desiFish/EPaper-Display-Weather-Clock/README.md

<div align="center">
  <h1>🌡️ Minimalistic E-Paper Weather Station</h1>
  <p>
    
    
    
    
  </p>
  <p>
    
    
    
    
  </p>
</div>

<p align="center">
  <i>🌈 A beautiful, eco-friendly weather station powered by E-Paper display! 🌱</i>
</p>

</div>

> ⚠️ **IMPORTANT**: Please read the [Notes & Warnings] section carefully before proceeding with this project. It contains crucial safety information about battery configuration, charging, and sensor placement.

<div align="center">

### 🌟 Smart • Efficient • Eco-Friendly 🌟

</div>

---

## 📝 Schematics

<div align="center">
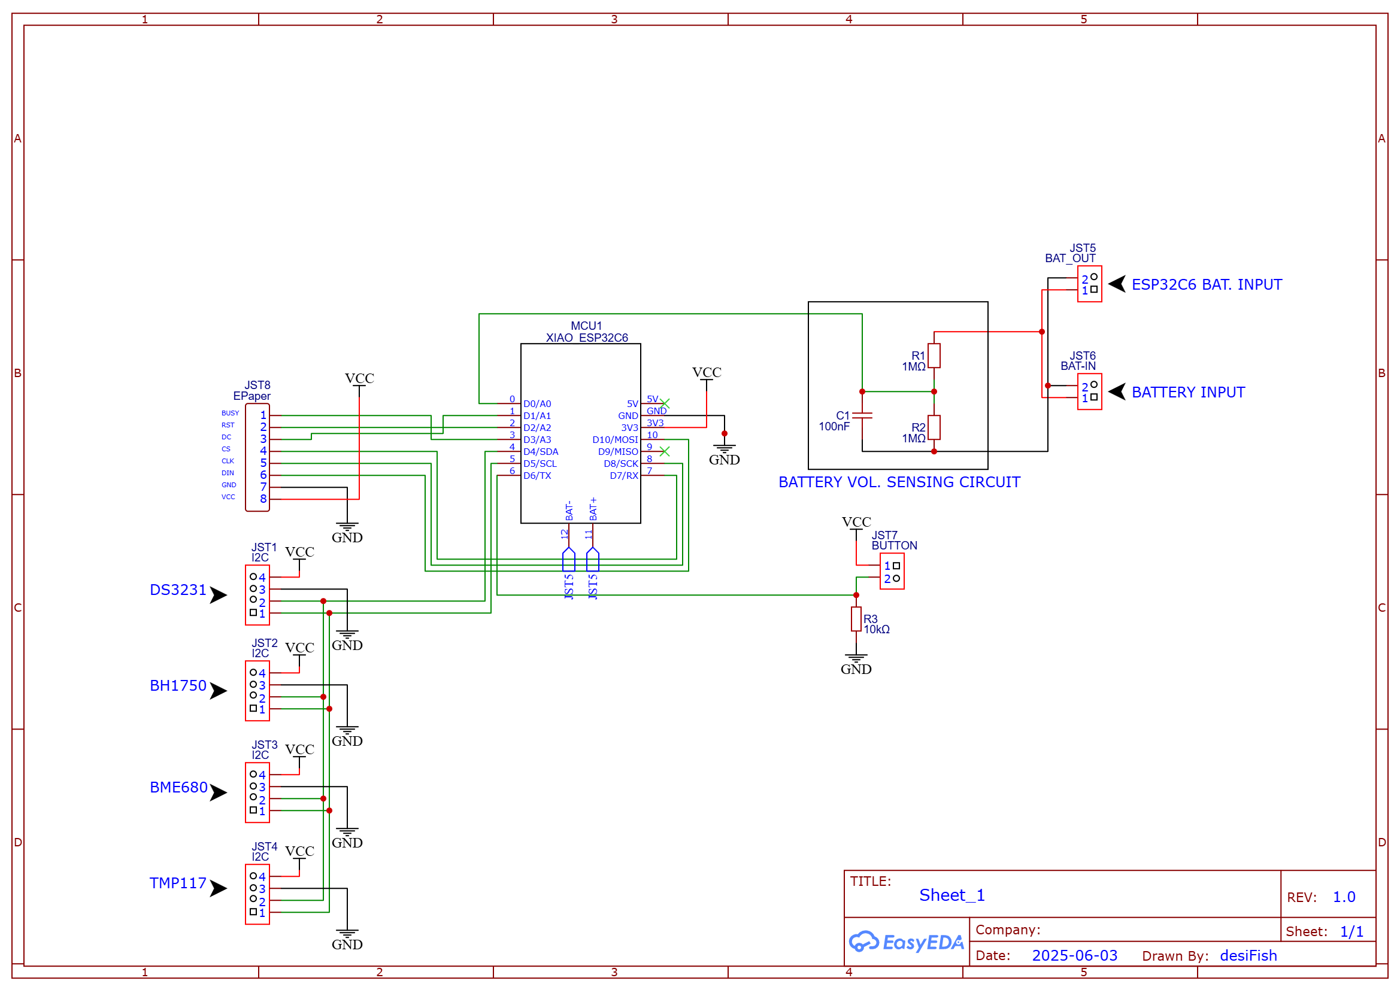
[picture p1: resources/schematic.png]
Circuit Schematics
  
  <p><i>Project Circuit Schematics</i></p>
</div>

## 🛠️ Hardware Components

<table>
  <tr>
    <td>🎯 <b>Tested On</b></td>
    <td>
      • Seeed Studio XIAO ESP32 C3<br>
      • Seeed Studio XIAO ESP32 C6
    </td>
  </tr>
  <tr>
    <td>📟 <b>Display</b></td>
    <td>Waveshare 4.2inch TriColor 400x300 E-paper (15s refresh)</td>
  </tr>
  <tr>
    <td>🌡️ <b>Sensors</b></td>
    <td>
      • TMP117 (Temperature)<br>
      • BH1750 (Light sensing)<br>
      • DS3231 (Time keeping)<br>
      • BME680 (Humidity & pressure)
    </td>
  </tr>
  <tr>
    <td>🔋 <b>Power</b></td>
    <td>LFP 2x4000mAh (8000mAh total) Lithium Iron Phosphate Battery (IFR26700)</td>
  </tr>
  <tr>
    <td>🔌 <b>Other</b></td>
    <td>2xBMS, capacitors, resistors, connectors, etc.</td>
  </tr>
</table>

## 📱 Key Features & Updates

<table>
<tr>
<td width="50%" align="center">
  
### 🆕 Latest Version
[**v0.4.0**](https://github.com/desiFish/ESP32-ePaper-Display-Weather-Clock/releases/tag/v0.4.0)
- 🔧 Enhanced overall system efficiency
- 💾 Improved readability
  
</td>
<td width="50%" align="center">

### 🎯 Coming Soon
- 📱 Web browser integration
- 🌐 Enhanced weather data graph
- 🎨 New display layouts
  
</td>
</tr>
</table>

## ⭐ Core Features

<div align="center">

🌡️ Medical-grade Temperature | 💧 Humidity & Pressure | 🔋 Smart Battery | 🌍 Weather Data
:-------------------------:|:-------------------------:|:-------------------------:|:-------------------------:
±0.1°C Precision | Real-time Monitoring | Intelligent Power Mgmt | Global Forecasting
`TMP117 Sensor` | `BME680 Sensor` | `2000+ Cycles` | `OpenWeatherMap`

</div>

### 🎮 Smart Features
• 🌙 Moon Phase & Day/Night Tracking  
• 🔄 Auto WiFi Configuration  
• ⏰ Power-efficient Sleep Modes  
• 📊 Environmental Monitoring

## ⚡ Power Performance

<div align="center">
  
### 🔋 Power Optimization Results




</div>

<div align="center">
<table style="width: 80%; margin: 20px auto; border: 2px solid #4CAF50; border-radius: 10px; padding: 15px;">
<tr>
<td style="text-align: center; background-color: #f8f9fa;">
<h3>🚀 Coming Soon: Ultra-Low Power Mode</h3>
<p style="color: #155724; background-color: #d4edda; padding: 10px; border-radius: 5px;">
Using SparkFun TPL5110 Timer + Power Management Board:<br>
Sleep Current Draw: 20µA → 35nA<br>
<b>That's a 571,328% reduction in sleep power consumption!</b>
</p>
<details>
<summary>💡 How it works</summary>
<p>The TPL5110 completely cuts power to the system between updates, reducing standby current to near-zero levels. This improvement will dramatically extend battery life!</p>
</details>
</td>
</tr>
</table>
</div>

> 📊 **Performance Metrics**
> 
> After recent code optimizations, power efficiency has significantly improved:
> 
> | Mode | Duration (Awake) | Status |
> |------|----------|---------|
> | Active-Active | ~27s |  |
> | Sleep-Active-Sleep | ~20s |  |
> | Sleep-to-Sleep | <1s |  |
>
> ✨ **Key Improvements**:
> - CPU power thoroughly monitored and conserved
> - Optimized mode transitions
> - Minimal wake time in sleep cycles

## 📊 Battery Performance

> 📝 **Note**: Historical data below is from testing with Li-ion ICR batteries. The shorter duration in cycles 2 and 3 (49 and 48 days vs 73 days) was due to incomplete charging (batteries not reaching full 4.2V). New performance data with 8000mAh LFP batteries (which are more cost-effective) is being collected.

### ICR Battery Data (OLD)
<details>
<table>
  <tr>
    <th>Cycle</th>
    <th>Duration</th>
    <th>Details</th>
  </tr>
  <tr>
    <td>First Cycle</td>
    <td>73 Days or 2 Months, 12 Days</td>
    <td>06/05/2024 - 17/07/2024</td>
  </tr>
  <tr>
    <td>Second Cycle</td>
    <td>49 Days</td>
    <td>~7 weeks</td>
  </tr>
  <tr>
    <td>Third Cycle</td>
    <td>48 Days</td>
    <td>~7 weeks</td>
  </tr>
</table>
</details>

### LFP Battery Data (NEW)
<table>
  <tr>
    <th>Cycle</th>
    <th>Duration</th>
    <th>Details</th>
  </tr>
  <tr>
    <td>First Cycle</td>
    <td>107 Days or 3 Months, 17 Days</td>
    <td>09/01/2025 - 18/04/2025</td>
  </tr>
  <tr>
    <td>Second Cycle</td>
    <td>134 Days or 4 Months, 12 Days</td>
    <td>18/04/2025 - 30/08/2025</td>
  </tr>
  <tr>
    <td>Third Cycle</td>
    <td>TBD</td>
    <td>13/08/2026 - TBD</td>
  </tr>
</table>

### Current Consumption
> ⚠️ **Note**: Precise current consumption measurements for the entire project are not available due to equipment limitations. Please refer to the Battery Performance section above for real-world usage data and longevity estimates.

## 📸 Gallery

<table style="border-spacing: 10px; border-collapse: separate;">
  <tr>
    <td width="33%" style="padding: 0;">
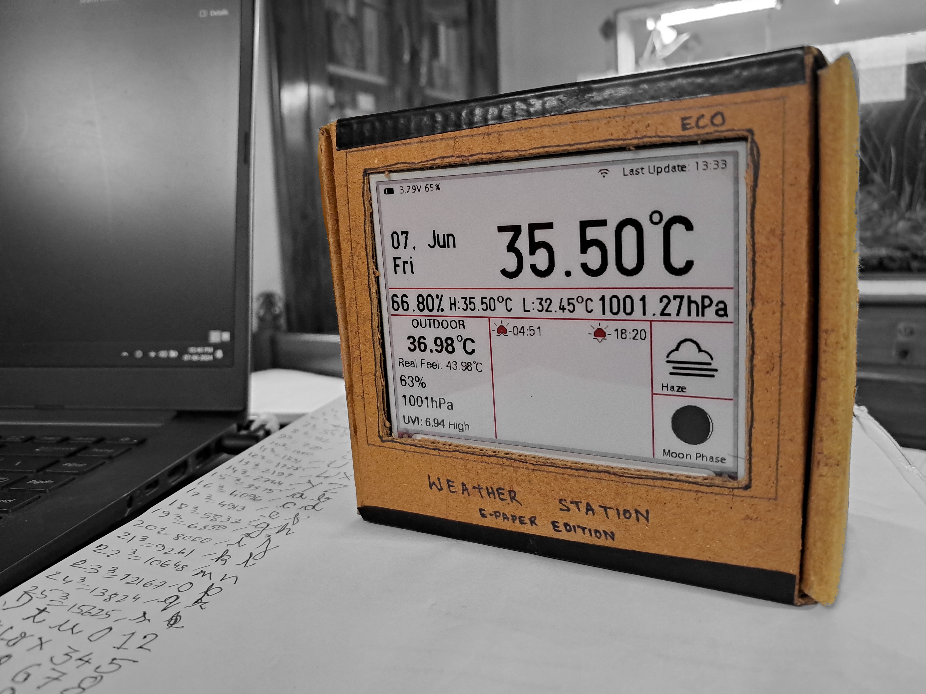
[picture p2: resources/epd.jpg]
Clock Normal Mode
      
      <p align="center"><i>Clock Normal Mode</i></p>
    </td>
    <td width="33%" style="padding: 0;">
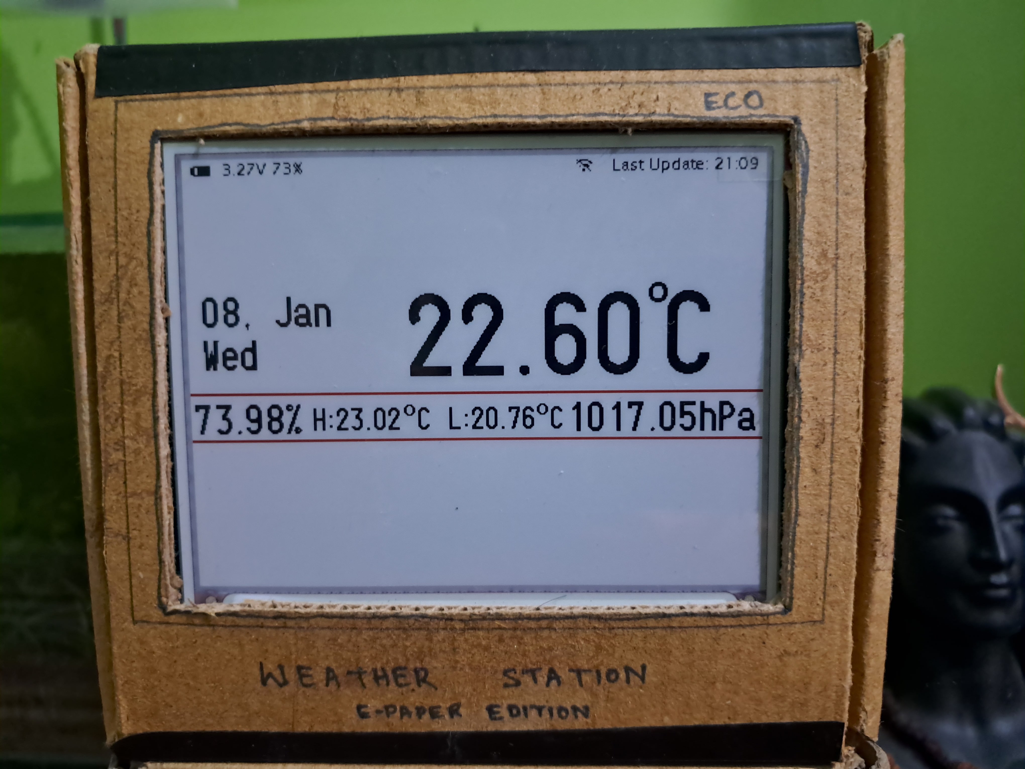
[picture p3: resources/epd2.jpg]
Clock Power Conserved Mode
      
      <p align="center"><i>Clock Power Conserved Mode</i></p>
    </td>
    <td width="33%" style="padding: 0;">
      Side View 1
      <p align="center"><i>Side View 1</i></p>
    </td>
  </tr>
  <tr>
    <td width="33%" style="padding: 0;">
      Back View
      <p align="center"><i>Back View</i></p>
    </td>
    <td width="33%" style="padding: 0;">
      Side View 2
      <p align="center"><i>Side View 2</i></p>
    </td>
    <td width="33%" style="padding: 0;">
      Top View
      <p align="center"><i>Top View</i></p>
    </td>
  </tr>
  <tr>
    <td width="33%" style="padding: 0;">
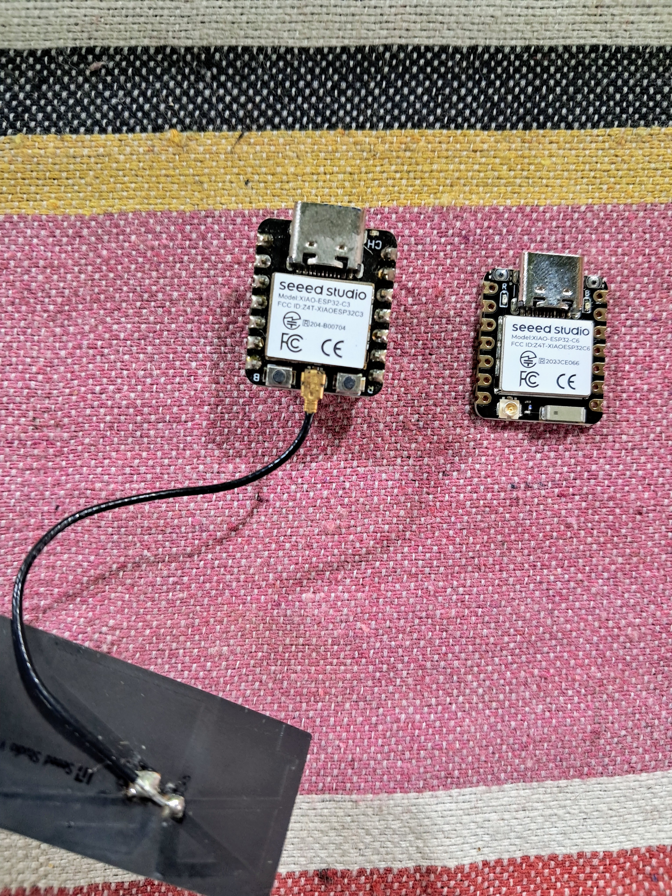
[picture p4: resources/epd7.jpg]
ESP32 Compared
      
      <p align="center"><i>ESP32 Compared</i></p>
    </td>
    <td width="33%" style="padding: 0;">
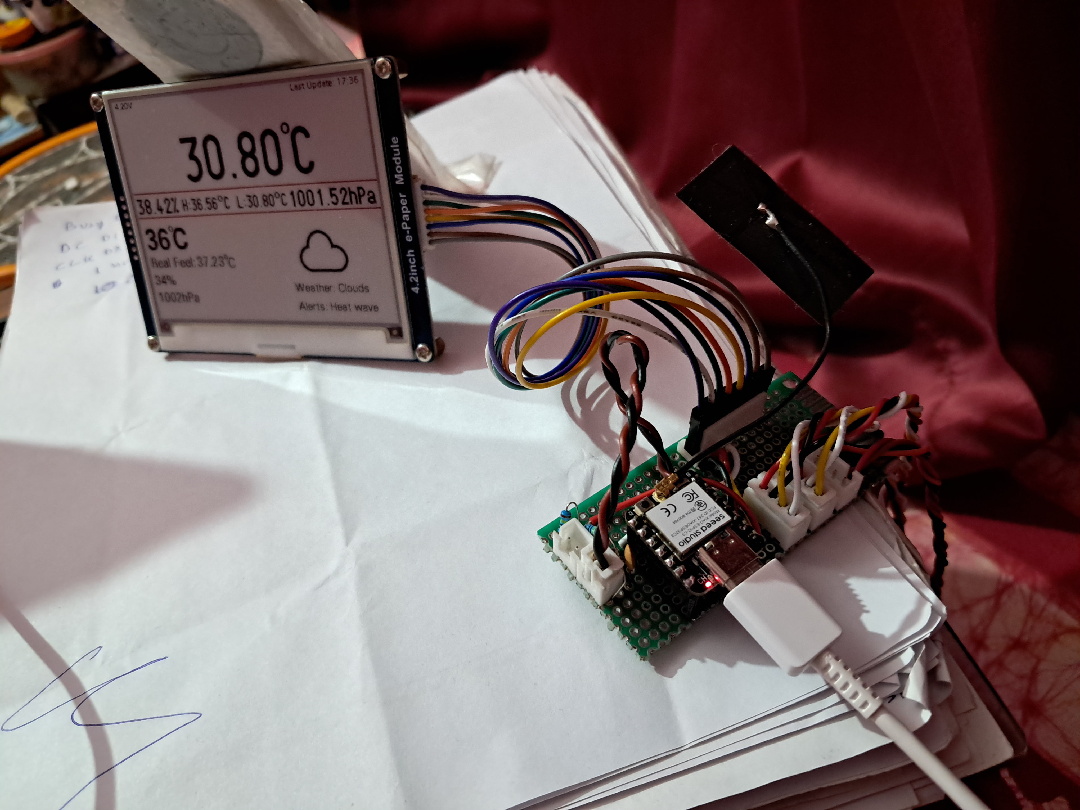
[picture p5: resources/epd8.jpg]
Testing
      
      <p align="center"><i>Testing</i></p>
    </td>
    <td width="33%" style="padding: 0;">
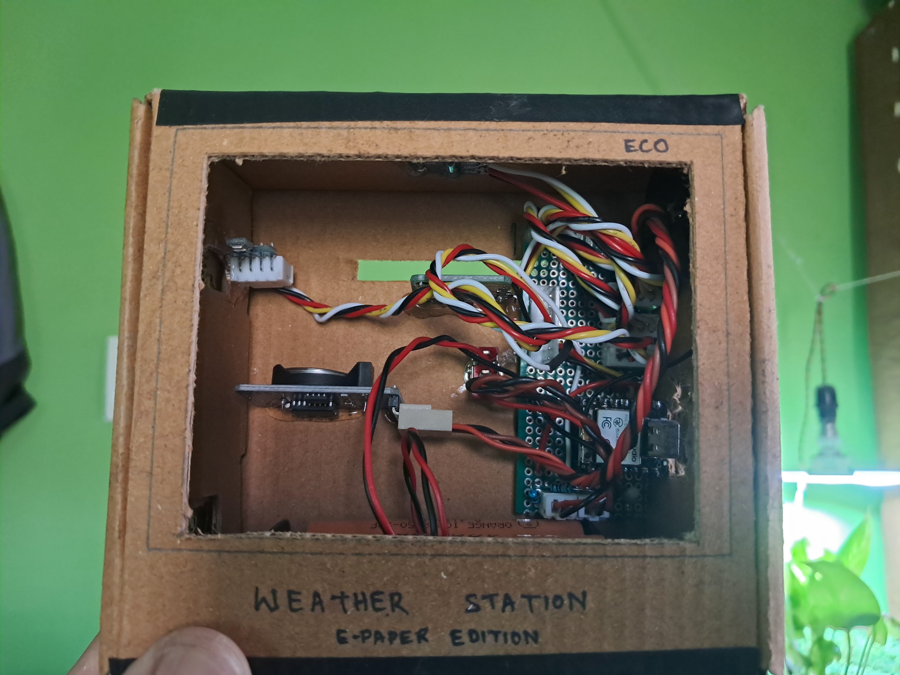
[picture p6: resources/epd9.jpg]
Integration
      
      <p align="center"><i>Integration</i></p>
    </td>
  </tr>
  <tr>
    <td width="33%" style="padding: 0;">
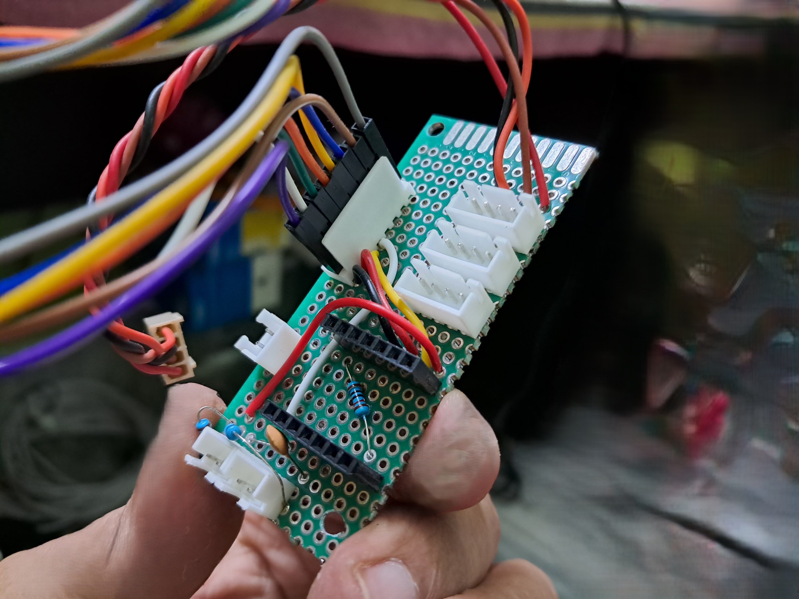
[picture p7: resources/epd10.jpg]
Mainboard Front
      
      <p align="center"><i>Mainboard Front</i></p>
    </td>
    <td width="33%" style="padding: 0;">
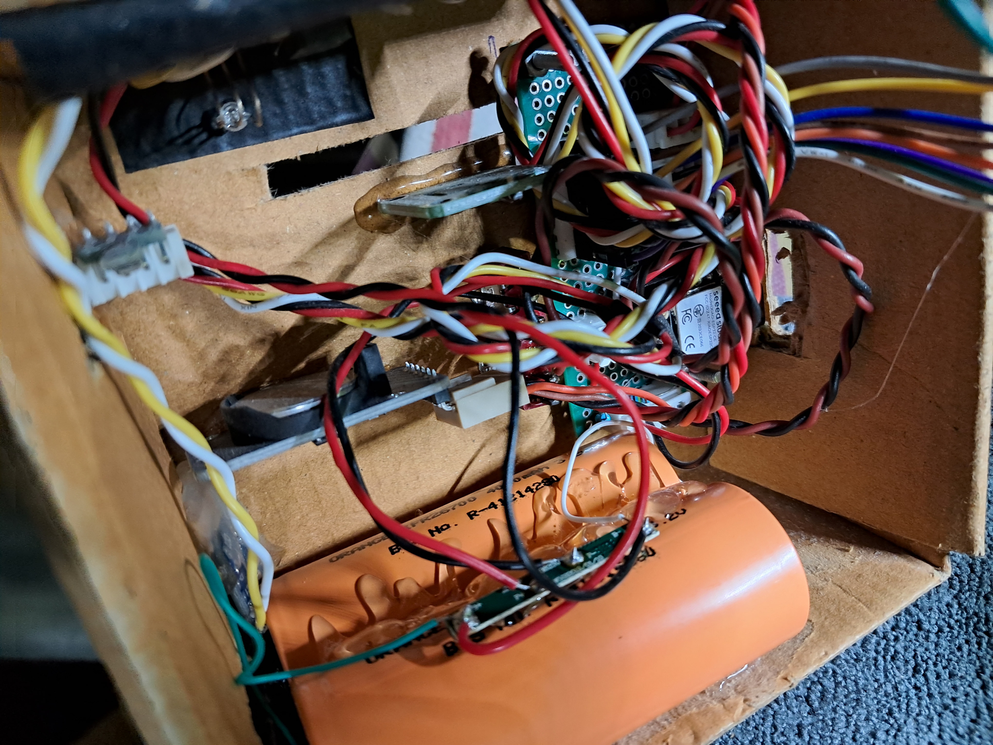
[picture p8: resources/epd11.jpg]
Internal 1
      
      <p align="center"><i>Internal 1</i></p>
    </td>
    <td width="33%" style="padding: 0;">
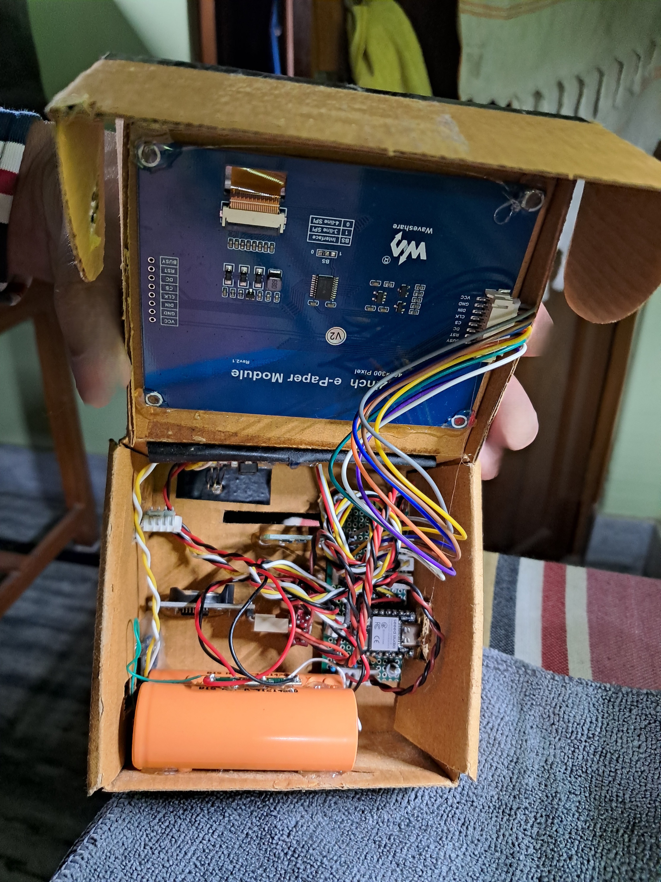
[picture p9: resources/epd12.jpg]
Internal 2
      
      <p align="center"><i>Internal 2</i></p>
    </td>
  </tr>
  <tr>
    <td width="33%" style="padding: 0;">
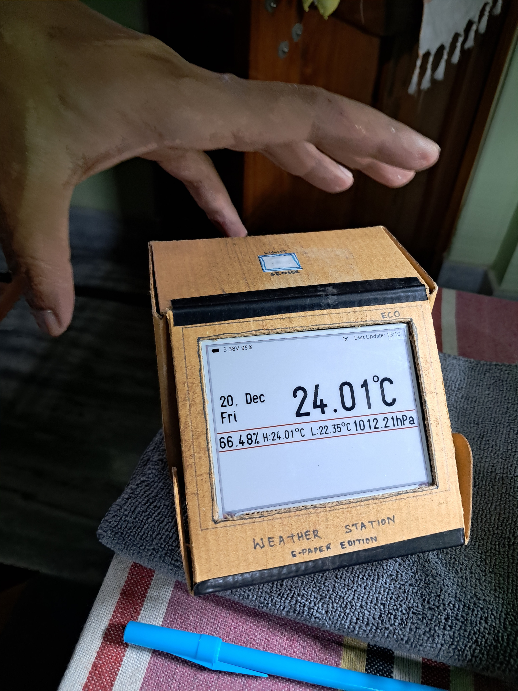
[picture p10: resources/epd13.jpg]
Facelift Clock
      
      <p align="center"><i>Facelift Clock</i></p>
    </td>
    <td width="33%" style="padding: 0;">
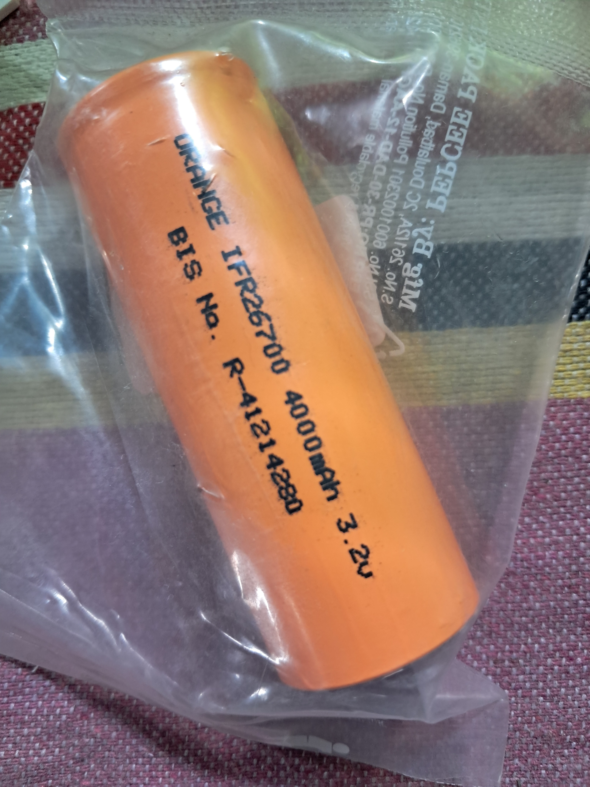
[picture p11: resources/epd14.jpg]
LiFePO4 Cell 4000mAh
      
      <p align="center"><i>LiFePO4 Cell 4000mAh</i></p>
    </td>
    <td width="33%" style="padding: 0;">
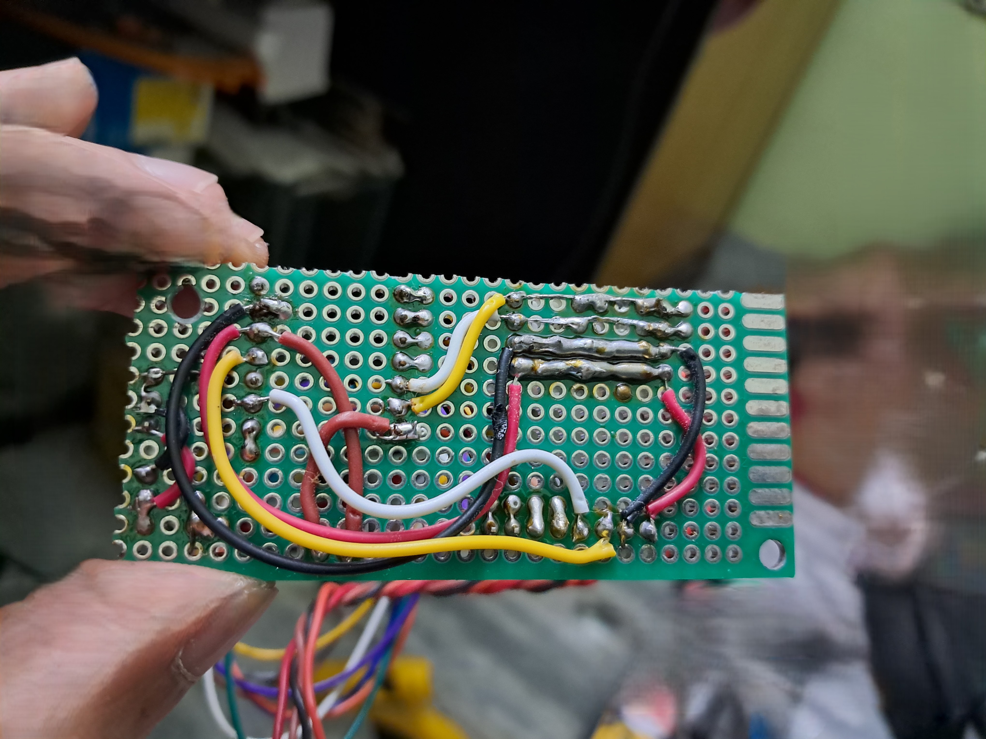
[picture p12: resources/epd15.jpg]
Mainboard Back
      
      <p align="center"><i>Mainboard Back</i></p>
    </td>
  </tr>
</table>

## 🌱 Eco-Friendly Features

- 📱 E-Paper Display (no backlight needed)
- 🔋 LiFePO4 Batteries (Lithium Iron Phosphate)
  - ✅ Cobalt-free chemistry, reducing environmental impact
  - ✅ 2-3x longer lifespan than traditional Li-ion
  - ✅ Non-toxic and more stable chemistry
  - ✅ Better recyclability due to simpler composition
- 📦 Recycled cardboard construction
- 💡 Smart light sensor for power saving

## 💫 Technical Specifications

<details>
<summary>🧠 Core System</summary>

### Core Components
- 💻 **XIAO ESP32 C6** (Recommended)
  - 32-bit RISC-V single-core CPU up to 160MHz
  - 320KB SRAM, 4MB Flash
  - WiFi 6 & Bluetooth 5.0
  - Ultra-low power consumption: ~14µA in deep sleep ([Source](https://sigmdel.ca/michel/ha/xiao/xiao_esp32c6_intro_en.html#deep_sleep))
    - Note: 14-15µA deep sleep current only achievable when power is supplied through battery pins (BAT+ and BAT-)
  - 11 Digital/Analog pins
  - USB-C interface
  - ⚠️ May experience reduced WiFi range due to integrated PCB antenna
    - Consider ESP32 C3 variant with external antenna for better signal strength
    - Signal strength highly dependent on enclosure material and placement

### Pin Differences Between C3 and C6
<div align="center">
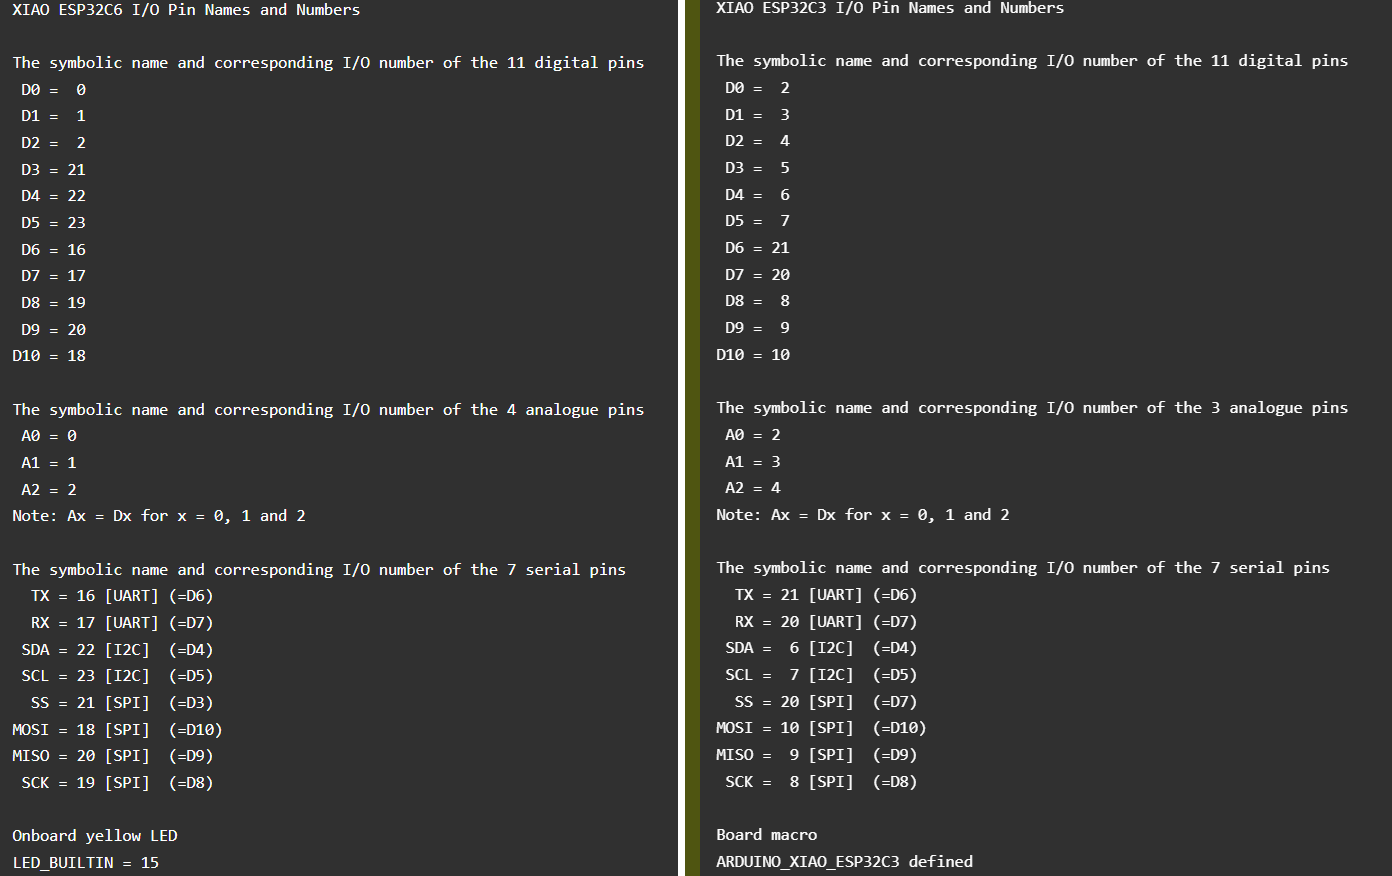
[picture p13: resources/epd18.png]
<br>
<table>
</table>
<p><i>Source: <a href="https://sigmdel.ca/michel/ha/xiao/xiao_esp32c6_intro_en.html#deep_sleep">sigmdel.ca</a></i></p>
</div>

### Power Consumption Comparison
- ⚡ **Deep Sleep Current**:
  - XIAO ESP32 C6: ~25µA total
    - 14.3µA from ESP32C6 core ([Source](https://sigmdel.ca/michel/ha/xiao/xiao_esp32c6_intro_en.html#deep_sleep))
    - ~11µA from all peripheral devices in standby (RTC, sensors, etc.)
  - XIAO ESP32 C3: Higher deep sleep current (~43µA, tested)
  - XIAO ESP32 S3: Potentially lower deep sleep current (~11.9µA, untested)
    - Not used due to project's modest performance needs
    - Could be viable alternative for maximum battery life

</details>

<details>
<summary>📡 Sensors & Connectivity</summary>

### Sensors
- 🌡️ TMP117 High-Precision Temperature Sensor
  - ±0.1°C (max) from -20°C to +50°C
  - 16-bit resolution (0.0078°C)
  - Low power: 3.5µA in shutdown mode
  - Temperature range: -55°C to +150°C
  
- 💨 Bosch BME680 Environmental Sensor
  - Humidity: ±3% accuracy
  - Pressure: ±0.6 hPa absolute accuracy
  - Gas sensor for air quality
  - Temperature range: -40°C to +85°C
  
- 💡 BH1750 Light Sensor
  - 1 - 65535 lux range
  - 16-bit resolution
  - Spectral responsivity close to human eye
  - Low power: 120µA active mode
  
- ⏰ DS3231 RTC Module
  - Accuracy: ±2ppm (±0.432 sec/day)
  - Temperature compensated crystal
  - Battery backup support
  - -40°C to +85°C operating range

</details>

<details>
<summary>⚡ Power System</summary>

### Power & Display
- 🔋 IFR26700 LiFePO4 Battery
  - Nominal voltage: 3.2V
  - Capacity: 4000mAh (8000mAh total with 2 cells)
  - Cycle life: >1000 min. cycles
  - Size: 26mm × 70mm
  - Max discharge current: 8A
  - Operating temperature: -20°C to +60°C
  - Self-discharge rate: <3% monthly
  - Battery critical threshold: 30%
    - Higher threshold significantly increases battery lifecycle ([Source](https://batteries.intercel.eu/knowledge-center/battery-technology/lithium-batteries/lifepo4-batteries/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,continue%20where%20other%20batteries%20stop.))
    - Urges to recharge at 30% remaining capacity
    - Preserves cell health for longer service life
    - Implemented in firmware via critBattPercent constant

- ⚡ TP5000 Charging Module
  - Input voltage: 4.5-8V
  - Charging current: 1000mA (adjustable)
  - Charging accuracy: ±1.5%
  - LiFePO4 mode: 3.6V cutoff
  - Over-voltage protection
  - Temperature protection
  - Short circuit protection

- 📟 Waveshare 4.2" E-Paper Display
  - Resolution: 400×300 pixels
  - Three colors: Black, White, Red
  - Active area: 84.8mm × 63.6mm
  - Refresh time: 15 seconds
  - Viewing angle: >170°
  - Operating voltage: 3.3V
  - Ultra-low power consumption
  - No backlight needed
  - SPI interface

</details>

<details>
<summary>📟 Display & Ghosting</summary>

### E-Paper Display Ghosting
- 👻 **Ghosting Issue**: Even after using full scan/update mode, ghosting can occur
  - Red lines may appear over black background
  - Occurs when same elements stay static for extended periods
  
- 🛡️ **GhostProtek Mode**
  - Automatically inverts display colors periodically
  - Activates after predetermined number of boots
  - Prevents static elements from burning in
  - Helps maintain display longevity
  - Experimental feature to reduce ghosting artifacts

</details>

## 🔧 Setup & Configuration

### Initial Setup
1. 📱 Power on the device
2. 🔄 Connect to `WCLOCK-WIFI-MANAGER` WiFi network
3. 🌐 Navigate to the IP address shown on the display
4. ⚙️ Enter your WiFi credentials
5. 🎉 Device will restart and connect to your network

### API Configuration
- 🔑 OpenWeatherMap API key required
- 🌍 Custom API support for personal weather station
- 📍 Configurable location (latitude/longitude)

### Debug Mode
- 🐛 Enable via DEBUG_PIN (D6)
- 📊 Shows network diagnostics
- 🔍 Displays detailed error messages

### Power Management
- 🔋 Battery voltage monitoring
- ⚡ Configurable sleep intervals (default: 15 mins)
- 🌙 Night mode with reduced updates
- 📉 Low battery failsafe mode

### Display Modes
1. Normal Mode
   - Full weather data
   - Temperature, humidity, pressure
   - Moon phase and weather icons
   - Sunrise/sunset times
2. Limited Mode (Low Battery)
   - Basic temperature display
   - Battery status
   - Time and date
3. Night Mode
   - Display sleeps when dark
   - 5-minute wake intervals
   - Power saving features

### Software Updates
- 🔄 **Current Update Method**:
  - No OTA (Over-The-Air) updates due to memory constraints
  - Manual update process required:
    1. Turn OFF the clock using flip switch
    2. Press and HOLD the debug button (D6)
    3. While holding debug button, turn ON the clock
    4. It will disable sleep
    5. Release debug button when display starts to refresh
    6. Display will show temperature and then "DEBUG MODE" (No need to wait for this)
    7. Connect to PC via USB-C cable
    8. Upload new code using Arduino IDE

## 🌿 Environmental Impact

<table>
<tr>
<td width="50%">

### 🔋 Power Efficiency
- 📱 No backlight needed
- 💤 Smart sleep modes
- ⚡ Low power sensors
- 🔆 Ambient light detection

</td>
<td width="50%">

### ♻️ Sustainability
- 🌱 Eco-friendly batteries
- 📦 Recycled materials
- 🔄 Long lifecycle
- 🌍 Low carbon footprint

</td>
</tr>
</table>

## ⚠️ Important Notes & Warnings

### 🔄 DS3231 Battery Safety ⚡
<div align="center">
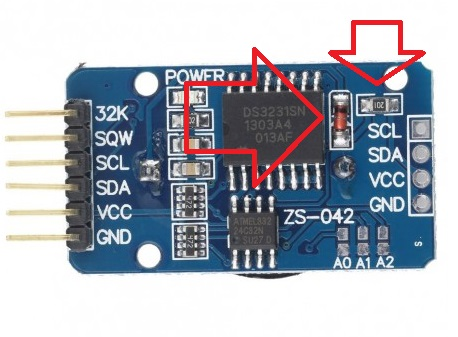
[picture p14: resources/epd16.jpeg]
<br>
Most DS3231 modules are sold with CR2032 or similar cells which are not rechargeable. If you are using a non-rechargeable cell then **REMOVE** either the resistor or the diode marked in the above image.
</div>

### 🔌 TP5000 Charging Configuration ⚡
<div align="center">
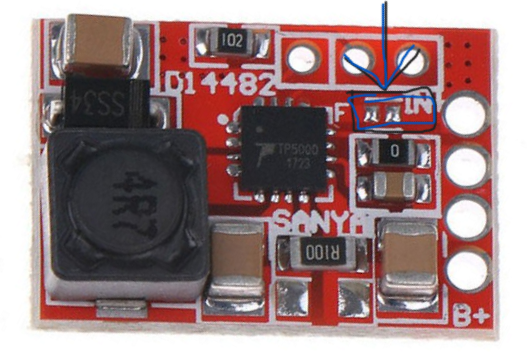
[picture p15: resources/epd17.png]
<br>
**IMPORTANT**: There are some misinformation over internet regarding the charging mode of TP5000. If you are using LiFePO4 cells with TP5000 then **DO NOT** short the above marked area with caption F.
</div>

### Battery Configuration Safety
- 🔋 **Parallel Cell Configuration**: While this project uses two LiFePO4 cells in parallel, this is generally not recommended with TP5000 or similar charging circuits
  - Currently safe due to verified cell balance
  - Long-term balance cannot be guaranteed
  - Only implemented due to ultra-low current draw

### Power Management Considerations
- ⚡ **Current Draw**: This project's extremely low current consumption (well below rated cell capacity) makes the parallel configuration safer
- 🛡️ **Protection**: Always use proper BMS protection for your cells
- 📝 **BMS Setup**: Due to limited 1S LiFePO4 BMS availability:
  - Using 4.2V BMS for 2.5V cutoff protection (Low Discharge Cutoff)
  - TP5000 connected directly to cells for proper 3.6V charging
  - This is a temporary solution until better 1S LFP BMS options become available

### USB Charging Safety
- ⚡ **USB Connection Warning**: Disconnect battery when connecting USB to ESP32C6
  - XIAO modules are designed for LiPo/Li-ion batteries (4.2V charging)
  - Not compatible with LFP battery charging (3.6V required)
  - Dedicated USB-C module recommended
  - Connect USB-C module output to TP5000 input
  - Detailed schematics will be provided later
  - Simple setup despite complex explanation

### Voltage Compatibility
- ✅ **Operating Range**: 
  - All components work perfectly with LFP's lower voltage
  - Tested operational down to 2.8V
  - No impact on battery life or performance
  - LFP cells maintain stable 3.2V for extended periods
  - 6+ months of testing
  - Components designed for wide voltage range operation

### Enclosure Design
- 💨 **Ventilation Requirements**: 
  - Proper air vents are crucial
  - Ensures accurate sensor readings
  - Prevents heat buildup
  - Essential for environmental monitoring
- 🔧 **Sensor Orientation**:
  - TMP117 and BME680 must be mounted horizontally
  - Sensors should face downward
  - Prevents dust and particle accumulation
  - Ensures accurate long-term readings

> ⚠️ **Please consider these points carefully before replicating this setup. Battery safety is crucial!**

## 🤝 Contributing

<div align="center">




</div>

## 📝 License & Credits

<table>
<tr>
<td>

### 📜 License
GNU General Public License v3.0
- ✅ Freedom to use commercially
- ✅ Freedom to modify
- ✅ Freedom to distribute
- ❗ Must be open source
- ❗ Must preserve copyright
- ❗ Must use same license

> 🙏 **Attribution Request**: If you use this code in your project, please include a link to this repository. Your support through attribution helps maintain and grow our open-source community. Thank you!
>
> ```markdown
> Based on [ESP32 E-Paper Weather Clock](https://github.com/desiFish/ESP32-ePaper-Display-Weather-Clock) by desiFish
> ```

</td>
<td>

### 👏 Credits
- 🎨 Weather icons by SeBassTian23
- 📚 GxEPD2 Library
- 💻 Community Contributors

</td>
</tr>
</table>

---

<div align="center">
  
### Made with 💖 and ♻️ materials

<br>



</div>
