desiFish/EPaper-Display-Weather-Clock/icons.cpp

#include "icons.h"
// ...existing code...

// 16x16 pixel gauge icon, 1-bit per pixel, example bitmap
const unsigned char gaugeIcon[] = {
    0x00, 0x00, 0x00, 0x00, 0x00, 0x00, 0x00, 0x00, 0x00, 0x00, 0x00, 0x00, 0x00, 0x00, 0x00, 0x00,
    0x00, 0x00, 0x00, 0x00, 0x00, 0x00, 0x00, 0x00, 0x00, 0x0e, 0x70, 0x00, 0x00, 0x7e, 0x7e, 0x00,
    0x01, 0xfe, 0x7f, 0x80, 0x03, 0xfe, 0x7f, 0xc0, 0x07, 0xfe, 0x7f, 0xe0, 0x0f, 0xf8, 0x1f, 0xf0,
    0x0f, 0xe0, 0x07, 0xf0, 0x07, 0x80, 0x01, 0xe0, 0x23, 0x00, 0x00, 0xc4, 0x70, 0x00, 0x00, 0x0e,
    0x78, 0x00, 0x00, 0x1e, 0x7c, 0x01, 0x80, 0x3e, 0xfc, 0x01, 0x80, 0x3f, 0xfc, 0x01, 0x80, 0x3f,
    0xf8, 0x01, 0x80, 0x1f, 0xf8, 0x01, 0x80, 0x1f, 0xf8, 0x01, 0x80, 0x1f, 0xf8, 0x03, 0xc0, 0x1f,
    0xfc, 0x03, 0xc0, 0x3f, 0xfc, 0x01, 0x80, 0x3f, 0x00, 0x00, 0x00, 0x00, 0x00, 0x00, 0x00, 0x00,
    0x00, 0x00, 0x00, 0x00, 0x00, 0x00, 0x00, 0x00, 0x00, 0x00, 0x00, 0x00, 0x00, 0x00, 0x00, 0x00};

const unsigned char humiIcon[] = {
    0x00, 0x01, 0x80, 0x00, 0x00, 0x03, 0xc0, 0x00, 0x00, 0x03, 0xc0, 0x00, 0x00, 0x07, 0xe0, 0x00,
    0x00, 0x0e, 0x70, 0x00, 0x00, 0x0c, 0x30, 0x00, 0x00, 0x18, 0x18, 0x00, 0x00, 0x38, 0x1c, 0x00,
    0x00, 0x70, 0x0e, 0x00, 0x00, 0x60, 0x06, 0x00, 0x00, 0xc0, 0x03, 0x00, 0x01, 0xc0, 0x03, 0x80,
    0x01, 0x8c, 0x01, 0x80, 0x03, 0x1e, 0x00, 0xc0, 0x07, 0x33, 0x0c, 0xe0, 0x06, 0x33, 0x1c, 0x60,
    0x06, 0x1e, 0x38, 0x60, 0x0c, 0x0c, 0x70, 0x30, 0x0c, 0x00, 0xe0, 0x30, 0x0c, 0x01, 0xc0, 0x30,
    0x0c, 0x03, 0x80, 0x30, 0x0c, 0x07, 0x00, 0x30, 0x0e, 0x0e, 0x30, 0x70, 0x06, 0x1c, 0x78, 0x60,
    0x06, 0x38, 0xcc, 0x60, 0x03, 0x30, 0xcc, 0xc0, 0x03, 0x80, 0x79, 0xc0, 0x01, 0xc0, 0x33, 0x80,
    0x00, 0xe0, 0x07, 0x00, 0x00, 0x7c, 0x3e, 0x00, 0x00, 0x1f, 0xf8, 0x00, 0x00, 0x07, 0xe0, 0x00};

// Helper function to invert colors
uint16_t invertColor(uint16_t color, bool invert)
{
    if (!invert)
        return color;
    if (color == GxEPD_BLACK)
        return GxEPD_WHITE;
    if (color == GxEPD_WHITE)
        return GxEPD_BLACK;
    if (color == GxEPD_RED)
        return GxEPD_WHITE;
    return color;
}

// takes battery percent (integer) as input and prints battery icon
void iconBattery(GxEPD2_3C<GxEPD2_420c_Z21, GxEPD2_420c_Z21::HEIGHT> &display, byte percent, bool invert, int16_t x, int16_t y)
{
    display.drawRect(x + 2, y, 12, 7, invertColor(GxEPD_BLACK, invert));
    display.drawRect(x, y + 1, 2, 5, invertColor(GxEPD_BLACK, invert));

    if (percent >= 95) // Full
        display.fillRect(x + 3, y, 10, 6, invertColor(GxEPD_BLACK, invert));
    else if (percent >= 85 && percent < 95) // ful-Med
        display.fillRect(x + 4, y, 9, 6, invertColor(GxEPD_BLACK, invert));
    else if (percent > 65 && percent < 85) // Med
        display.fillRect(x + 5, y, 9, 6, invertColor(GxEPD_BLACK, invert));
    else if (percent > 40 && percent <= 65) // half
        display.fillRect(x + 7, y, 7, 6, invertColor(GxEPD_BLACK, invert));
    else if (percent > 20 && percent <= 40) // low
        display.fillRect(x + 9, y, 5, 6, invertColor(GxEPD_BLACK, invert));
    else if (percent > 8 && percent <= 20) // critical-low
        display.fillRect(x + 10, y + 1, 3, 5, invertColor(GxEPD_RED, invert));
    else
    { // near empty
        display.drawRect(x + 2, y, 12, 7, invertColor(GxEPD_RED, invert));
        display.drawRect(x, y + 1, 2, 5, invertColor(GxEPD_RED, invert));
    }
}

void fillEllipsis(GxEPD2_3C<GxEPD2_420c_Z21, GxEPD2_420c_Z21::HEIGHT> &display, uint16_t x, uint16_t y, uint16_t w, uint16_t h, uint16_t c, bool invert)
{
    for (int yi = -h; yi <= h; yi++)
    {
        for (int xi = -w; xi <= w; xi++)
        {
            if (xi * xi * h * h + yi * yi * w * w <= h * h * w * w)
                display.writePixel(x + xi, y + yi, invertColor(c, invert));
        }
    }
}

// Copy all the remaining icon function implementations from the original file here
// ...existing icon function implementations...

// Separate the icons in future update to separate file
void iconCloud(GxEPD2_3C<GxEPD2_420c_Z21, GxEPD2_420c_Z21::HEIGHT> &display, uint16_t x, uint16_t y, uint16_t r, bool invert)
{
    // top circle
    display.fillCircle(x, y, r, invertColor(GxEPD_BLACK, invert));
    // left circle
    display.fillCircle(x - r * 0.85, y + r * 0.8, r * 0.85, invertColor(GxEPD_BLACK, invert));
    // right circle
    display.fillCircle(x + r * 1.1, y + r * 0.8, r * 0.85, invertColor(GxEPD_BLACK, invert));
    // rectangle
    display.fillRect(x - r * 0.85, y + r * 0.8, (x + r * 1.1) - (x - r * 0.85), r * 0.9, invertColor(GxEPD_BLACK, invert));

    // top circle
    float offset = 0.8;
    display.fillCircle(x, y, r * offset, invertColor(GxEPD_WHITE, invert));
    // left circle
    display.fillCircle(x - r * 0.85, y + r * 0.8, r * 0.85 * offset, invertColor(GxEPD_WHITE, invert));
    // right circle
    display.fillCircle(x + r * 1.1, y + r * 0.8, r * 0.85 * offset, invertColor(GxEPD_WHITE, invert));
    // rectangle
    display.fillRect(x - r * 0.85, y + r * 0.7, (x + r * 1.1) - (x - r * 0.85), r * offset, invertColor(GxEPD_WHITE, invert));
}

void iconSun(GxEPD2_3C<GxEPD2_420c_Z21, GxEPD2_420c_Z21::HEIGHT> &display, uint16_t x, uint16_t y, uint16_t r, bool invert)
{
    display.drawLine(x - r * 1.75, y, x + r * 1.75, y, invertColor(GxEPD_BLACK, invert));
    display.drawLine(x, y - r * 1.75, x, y + r * 1.75, invertColor(GxEPD_BLACK, invert));
    display.drawLine(x - r * 1.25, y - r * 1.25, x + r * 1.25, y + r * 1.25, invertColor(GxEPD_BLACK, invert));
    display.drawLine(x - r * 1.25, y + r * 1.25, x + r * 1.25, y - r * 1.25, invertColor(GxEPD_BLACK, invert));
    display.fillCircle(x, y, r * 1.2, invertColor(GxEPD_WHITE, invert));
    display.fillCircle(x, y, r, invertColor(GxEPD_BLACK, invert));
    float offset = 0.9;
    display.fillCircle(x, y, r * offset, invertColor(GxEPD_RED, invert));
}

void iconMoon(GxEPD2_3C<GxEPD2_420c_Z21, GxEPD2_420c_Z21::HEIGHT> &display, uint16_t x, uint16_t y, uint16_t r, bool invert)
{
    float offset = 0.9;
    display.fillCircle(x, y, r, invertColor(GxEPD_BLACK, invert));
    display.fillCircle(x, y, r * offset, invertColor(GxEPD_RED, invert));
    display.fillCircle(x + r, y - r, r, invertColor(GxEPD_BLACK, invert));
    display.fillCircle(x + r, y - r, r * offset, invertColor(GxEPD_WHITE, invert));
    display.fillRect(x, y - r * 2, r * 2.5, r, invertColor(GxEPD_WHITE, invert));
    display.fillRect(x + r + 1, y - r, r * 1.5, r * 1.5, invertColor(GxEPD_WHITE, invert));
}

void iconClearDay(GxEPD2_3C<GxEPD2_420c_Z21, GxEPD2_420c_Z21::HEIGHT> &display, uint16_t x, uint16_t y, uint16_t s, bool invert)
{
    iconSun(display, x + s / 2, y + s / 2, s / 5, invert);
}

void iconClearNight(GxEPD2_3C<GxEPD2_420c_Z21, GxEPD2_420c_Z21::HEIGHT> &display, uint16_t x, uint16_t y, uint16_t s, bool invert)
{
    iconMoon(display, x + s / 2, y + s / 2, s / 5, invert);
}

void iconRain(GxEPD2_3C<GxEPD2_420c_Z21, GxEPD2_420c_Z21::HEIGHT> &display, uint16_t x, uint16_t y, uint16_t s, bool invert)
{
    iconCloud(display, x + s / 2.2, y + s / 2.5, s / 5, invert);
    display.fillRect(x + s * 0.275, y + s * 0.6, s / 2.5, s / 5, invertColor(GxEPD_WHITE, invert));

    float offset = 0.8;
    for (int i = 0; i <= s * 0.1; i++)
    {
        display.fillCircle(x + s * 0.4 - i * 0.5, y + s * 0.65 + i, s * 0.02, invertColor(GxEPD_BLACK, invert));
        display.fillCircle(x + s * 0.6 - i * 0.5, y + s * 0.65 + i, s * 0.02, invertColor(GxEPD_BLACK, invert));
    }
    for (int i = 0; i <= s * 0.16; i++)
    {
        display.fillCircle(x + s * 0.5 - i * 0.5, y + s * 0.65 + i, s * 0.02, invertColor(GxEPD_BLACK, invert));
    }
}

void iconSleet(GxEPD2_3C<GxEPD2_420c_Z21, GxEPD2_420c_Z21::HEIGHT> &display, uint16_t x, uint16_t y, uint16_t s, bool invert)
{
    iconCloud(display, x + s / 2.2, y + s / 2.5, s / 5, invert);
    display.fillRect(x + s * 0.275, y + s * 0.6, s / 2.5, s / 5, invertColor(GxEPD_WHITE, invert));

    float offset = 0.8;
    for (int i = 0; i <= s * 0.1; i++)
    {
        if (i < 1 || i > s * 0.1 * 0.5)
        {
            display.fillCircle(x + s * 0.4 - i * 0.5, y + s * 0.65 + i, s * 0.02, invertColor(GxEPD_BLACK, invert));
            display.fillCircle(x + s * 0.6 - i * 0.5, y + s * 0.65 + i, s * 0.02, invertColor(GxEPD_BLACK, invert));
        }
    }
    for (int i = 0; i <= s * 0.16; i++)
    {
        if (i < s * 0.16 * 0.5 || i > s * 0.16 * 0.8)
            display.fillCircle(x + s * 0.5 - i * 0.5, y + s * 0.65 + i, s * 0.02, invertColor(GxEPD_BLACK, invert));
    }
}

void iconSnow(GxEPD2_3C<GxEPD2_420c_Z21, GxEPD2_420c_Z21::HEIGHT> &display, uint16_t x, uint16_t y, uint16_t s, bool invert)
{
    iconCloud(display, x + s / 2.2, y + s / 2.5, s / 5, invert);
    display.fillRect(x + s * 0.275, y + s * 0.6, s / 2.5, s / 5, invertColor(GxEPD_WHITE, invert));

    float offset = 0.8;
    display.fillCircle(x + s / 2.75, y + s * 0.7, s * 0.02, invertColor(GxEPD_BLACK, invert));
    display.fillCircle(x + s / 1.75, y + s * 0.7, s * 0.02, invertColor(GxEPD_BLACK, invert));

    display.fillCircle(x + s / 2.75, y + s * 0.8, s * 0.02, invertColor(GxEPD_BLACK, invert));
    display.fillCircle(x + s / 1.75, y + s * 0.8, s * 0.02, invertColor(GxEPD_BLACK, invert));

    display.fillCircle(x + s / 2.15, y + s * 0.65, s * 0.02, invertColor(GxEPD_BLACK, invert));
    display.fillCircle(x + s / 2.15, y + s * 0.75, s * 0.02, invertColor(GxEPD_BLACK, invert));
    display.fillCircle(x + s / 2.15, y + s * 0.85, s * 0.02, invertColor(GxEPD_BLACK, invert));
}

void iconWind(GxEPD2_3C<GxEPD2_420c_Z21, GxEPD2_420c_Z21::HEIGHT> &display, uint16_t x, uint16_t y, uint16_t s, bool invert)
{
    float offset = 0.8;
    for (int i = 0; i <= s * 0.7; i++)
    {
        if (i < s * 0.6)
            display.fillCircle(x + s * 0.15 + i, y + s * 0.4, s * 0.02, invertColor(GxEPD_BLACK, invert));
        if (i < s * 0.5)
            display.fillCircle(x + s * 0.1 + i, y + s * 0.5, s * 0.02, invertColor(GxEPD_BLACK, invert));
        if (i < s * 0.2)
            display.fillCircle(x + s * 0.7 + i, y + s * 0.5, s * 0.02, invertColor(GxEPD_BLACK, invert));
        if (i < s * 0.6)
            display.fillCircle(x + s * 0.2 + i, y + s * 0.6, s * 0.02, invertColor(GxEPD_BLACK, invert));
    }
}

void iconFog(GxEPD2_3C<GxEPD2_420c_Z21, GxEPD2_420c_Z21::HEIGHT> &display, uint16_t x, uint16_t y, uint16_t s, bool invert)
{
    iconCloud(display, x + s / 2.2, y + s / 2.5, s / 5, invert);
    display.fillRect(x + s * 0.1, y + s * 0.55, s * 0.75, s / 5, invertColor(GxEPD_WHITE, invert));

    float offset = 0.8;
    for (int i = 0; i <= s * 0.7; i++)
    {
        display.fillCircle(x + s * 0.1 + i, y + s * 0.6, s * 0.02, invertColor(GxEPD_BLACK, invert));
        display.fillCircle(x + s * 0.2 + i, y + s * 0.7, s * 0.02, invertColor(GxEPD_BLACK, invert));
        display.fillCircle(x + s * 0.15 + i, y + s * 0.8, s * 0.02, invertColor(GxEPD_BLACK, invert));
    }
}

void iconCloudy(GxEPD2_3C<GxEPD2_420c_Z21, GxEPD2_420c_Z21::HEIGHT> &display, uint16_t x, uint16_t y, uint16_t s, bool invert)
{
    iconCloud(display, x + (s / 4) * 3, y + s / 4, s / 10, invert);
    iconCloud(display, x + s / 2.1, y + s / 2.2, s / 5, invert);
}

void iconCloudyDay(GxEPD2_3C<GxEPD2_420c_Z21, GxEPD2_420c_Z21::HEIGHT> &display, uint16_t x, uint16_t y, uint16_t s, bool invert)
{
    iconSun(display, x + (s / 3) * 2, y + s / 2.5, s / 6, invert);
    iconCloud(display, x + s / 2.2, y + s / 2.2, s / 5, invert);
}

void iconCloudyNight(GxEPD2_3C<GxEPD2_420c_Z21, GxEPD2_420c_Z21::HEIGHT> &display, uint16_t x, uint16_t y, uint16_t s, bool invert)
{
    iconMoon(display, x + (s / 3) * 2, y + s / 3, s / 6, invert);
    iconCloud(display, x + s / 2.2, y + s / 2.2, s / 5, invert);
}

void iconHail(GxEPD2_3C<GxEPD2_420c_Z21, GxEPD2_420c_Z21::HEIGHT> &display, uint16_t x, uint16_t y, uint16_t s, bool invert)
{
    iconCloud(display, x + s / 2.2, y + s / 2.5, s / 5, invert);
    display.fillRect(x + s * 0.275, y + s * 0.6, s / 2.5, s / 5, invertColor(GxEPD_WHITE, invert));

    float offset = 0.8;
    for (int i = 0; i <= s * 0.1; i++)
    {
        if (i < s * 0.1 * 0.5 || i == s * 0.1)
        {
            display.fillCircle(x + s * 0.4 - i * 0.5, y + s * 0.65 + i, s * 0.02, invertColor(GxEPD_BLACK, invert));
            display.fillCircle(x + s * 0.6 - i * 0.5, y + s * 0.65 + i, s * 0.02, invertColor(GxEPD_BLACK, invert));
        }
    }
    for (int i = 0; i <= s * 0.16; i++)
    {
        if (i < s * 0.16 * 0.7 || i == s * 0.16)
            display.fillCircle(x + s * 0.5 - i * 0.5, y + s * 0.65 + i, s * 0.02, invertColor(GxEPD_BLACK, invert));
    }
}

void iconThunderstorm(GxEPD2_3C<GxEPD2_420c_Z21, GxEPD2_420c_Z21::HEIGHT> &display, uint16_t x, uint16_t y, uint16_t s, bool invert)
{
    iconCloud(display, x + s / 2.2, y + s / 2.5, s / 5, invert);
    display.fillRect(x + s * 0.275, y + s * 0.6, s / 2.5, s / 5, invertColor(GxEPD_WHITE, invert));

    float offset = 0.8;
    for (int i = 0; i <= s * 0.1; i++)
    {
        display.fillCircle(x + s * 0.6 - i * 0.5, y + s * 0.65 + i, s * 0.02, invertColor(GxEPD_BLACK, invert));
    }
    for (int i = 0; i <= s * 0.16; i++)
    {
        display.fillCircle(x + s * 0.5 - i * 0.5, y + s * 0.65 + i, s * 0.02, invertColor(GxEPD_BLACK, invert));
    }
    display.fillTriangle(x + s * 0.3, y + s * 0.75, x + s * 0.325, y + s * 0.65, x + s * 0.375, y + s * 0.65, invertColor(GxEPD_RED, invert));
    display.fillTriangle(x + s * 0.3, y + s * 0.75, x + s * 0.4, y + s * 0.7, x + s * 0.33, y + s * 0.7, invertColor(GxEPD_RED, invert));
    display.fillTriangle(x + s * 0.3, y + s * 0.85, x + s * 0.35, y + s * 0.7, x + s * 0.4, y + s * 0.7, invertColor(GxEPD_RED, invert));
}

void iconTornado(GxEPD2_3C<GxEPD2_420c_Z21, GxEPD2_420c_Z21::HEIGHT> &display, uint16_t x, uint16_t y, uint16_t s, bool invert)
{
    // 1
    fillEllipsis(display, x + s * 0.33, y + s * 0.7, s / 12 * 1.2, s / 18 * 1.2, invertColor(GxEPD_BLACK, invert), invert);
    fillEllipsis(display, x + s * 0.33, y + s * 0.7, s / 12, s / 18, invertColor(GxEPD_WHITE, invert), invert);
    // 2
    fillEllipsis(display, x + s * 0.32, y + s * 0.65, s / 9 * 1.2, s / 16 * 1.2, invertColor(GxEPD_BLACK, invert), invert);
    fillEllipsis(display, x + s * 0.32, y + s * 0.65, s / 9, s / 16, invertColor(GxEPD_WHITE, invert), invert);
    // 3
    fillEllipsis(display, x + s * 0.35, y + s * 0.55, s / 7 * 1.2, s / 12 * 1.2, invertColor(GxEPD_BLACK, invert), invert);
    fillEllipsis(display, x + s * 0.35, y + s * 0.55, s / 7, s / 12, invertColor(GxEPD_WHITE, invert), invert);
    // 4
    fillEllipsis(display, x + s * 0.425, y + s * 0.425, s / 5 * 1.2, s / 8 * 1.2, invertColor(GxEPD_BLACK, invert), invert);
    fillEllipsis(display, x + s * 0.425, y + s * 0.425, s / 5, s / 8, invertColor(GxEPD_WHITE, invert), invert);
    // 5
    fillEllipsis(display, x + s * 0.5, y + s * 0.3, s / 4 * 1.2, s / 7 * 1.2, invertColor(GxEPD_BLACK, invert), invert);
    fillEllipsis(display, x + s * 0.5, y + s * 0.3, s / 4, s / 7, invertColor(GxEPD_WHITE, invert), invert);
}

// Takes x,y coordinates and radius r and phase. Phase denotes Moons current shape
void iconMoonPhase(GxEPD2_3C<GxEPD2_420c_Z21, GxEPD2_420c_Z21::HEIGHT> &display, uint16_t x, uint16_t y, uint16_t r, float phase, bool invert)
{
    display.fillCircle(x, y, r, invertColor(GxEPD_WHITE, invert));
    display.drawCircle(x, y, r, invertColor(GxEPD_BLACK, invert));
    if (phase == 0)
        display.fillCircle(x, y, r, invertColor(GxEPD_BLACK, invert)); // New Moon
    else if (phase > 0 && phase < 0.5)
    {
        for (int i = 0; i < r + 1; i++)
        {
            float cx = sqrt((r * r) - (i * i));
            float c2 = cx * 2 * (1 - (phase * 2));
            display.drawLine(x - cx, y + i, x - cx + c2, y + i, invertColor(GxEPD_BLACK, invert));
            display.drawLine(x - cx, y - i, x - cx + c2, y - i, invertColor(GxEPD_BLACK, invert));
        }
    }
    else if (phase == 0.5)
        ; // display.fillCircle(x, y, r, invertColor(GxEPD_RED, invert));  //Full Moon
    else
    {
        display.fillCircle(x, y, r, invertColor(GxEPD_BLACK, invert));
        for (int i = 0; i < r + 1; i++)
        {
            float cx = sqrt((r * r) - (i * i));
            float c2 = cx * 2 * ((1 - phase) * 2);
            display.drawLine(x - cx, y + i, x - cx + c2, y + i, invertColor(GxEPD_WHITE, invert));
            display.drawLine(x - cx, y - i, x - cx + c2, y - i, invertColor(GxEPD_WHITE, invert));
        }
        display.drawCircle(x, y, r, invertColor(GxEPD_BLACK, invert));
    }

    // Add moon surface on top
    display.drawPixel(x - r + 22, y - r + 1, invertColor(GxEPD_BLACK, invert));
    display.drawPixel(x - r + 12, y - r + 3, invertColor(GxEPD_BLACK, invert));
    display.drawPixel(x - r + 24, y - r + 3, invertColor(GxEPD_BLACK, invert));
    display.drawPixel(x - r + 13, y - r + 4, invertColor(GxEPD_BLACK, invert));
    display.drawPixel(x - r + 15, y - r + 4, invertColor(GxEPD_BLACK, invert));
    display.drawPixel(x - r + 17, y - r + 4, invertColor(GxEPD_BLACK, invert));
    display.drawPixel(x - r + 24, y - r + 4, invertColor(GxEPD_BLACK, invert));
    display.drawPixel(x - r + 26, y - r + 4, invertColor(GxEPD_BLACK, invert));
    display.drawPixel(x - r + 10, y - r + 5, invertColor(GxEPD_BLACK, invert));
    display.drawPixel(x - r + 17, y - r + 5, invertColor(GxEPD_BLACK, invert));
    display.drawPixel(x - r + 26, y - r + 5, invertColor(GxEPD_BLACK, invert));
    display.drawPixel(x - r + 15, y - r + 6, invertColor(GxEPD_BLACK, invert));
    display.drawPixel(x - r + 17, y - r + 6, invertColor(GxEPD_BLACK, invert));
    display.drawPixel(x - r + 19, y - r + 6, invertColor(GxEPD_BLACK, invert));
    display.drawPixel(x - r + 7, y - r + 7, invertColor(GxEPD_BLACK, invert));
    display.drawPixel(x - r + 14, y - r + 7, invertColor(GxEPD_BLACK, invert));
    display.drawPixel(x - r + 16, y - r + 7, invertColor(GxEPD_BLACK, invert));
    display.drawPixel(x - r + 18, y - r + 7, invertColor(GxEPD_BLACK, invert));
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
    display.drawPixel(x - r + 15, y - r + 30, invertColor(GxEPD_BLACK, invert));
    display.drawPixel(x - r + 19, y - r + 30, invertColor(GxEPD_BLACK, invert));
    display.drawPixel(x - r + 17, y - r + 31, invertColor(GxEPD_BLACK, invert));
}

// direction=true (UP), direction=false (DOWN)
void iconSunRise(GxEPD2_3C<GxEPD2_420c_Z21, GxEPD2_420c_Z21::HEIGHT> &display, uint16_t x, uint16_t y, bool direction, bool invert)
{
    uint16_t r = 7;

    // Horizontal
    display.drawLine(x - r * 2 + 2, y, x + r * 2 - 2, y, invertColor(GxEPD_BLACK, invert));
    // Vertical
    display.drawLine(x, y - r * 2 + 2, x, y, invertColor(GxEPD_BLACK, invert));
    // Angle Top right
    display.drawLine(x - r * 2 + 5, y - r * 2 + 5, x, y, invertColor(GxEPD_BLACK, invert));
    // Angle Top left
    display.drawLine(x, y, x + r * 2 - 5, y - r * 2 + 5, invertColor(GxEPD_BLACK, invert));
    // Remove lines inside
    display.fillCircle(x, y, r + 1, invertColor(GxEPD_WHITE, invert));
    // Empty inside
    display.fillCircle(x, y, r - 1, invertColor(GxEPD_RED, invert));
    display.drawCircle(x, y, r - 1, invertColor(GxEPD_BLACK, invert));
    // Overwrite the bottom
    display.fillRect(x - r, y + 4, r * 2, r, invertColor(GxEPD_WHITE, invert));

    // Arrow up
    if (direction == true)
    {
        display.fillTriangle(x - r / 2 - 1, y + r - 2, x, y + r - 7, x + r / 2 + 1, y + r - 2, invertColor(GxEPD_WHITE, invert));
        display.drawLine(x - r / 2, y + r - 2, x, y + r - 6, invertColor(GxEPD_BLACK, invert));
        display.drawLine(x, y + r - 6, x + r / 2, y + r - 2, invertColor(GxEPD_BLACK, invert));
    }
    // Arrow DOWN
    if (direction == false)
    {
        display.drawLine(x - r / 2, y + r - 2, x, y + r + 2, invertColor(GxEPD_BLACK, invert));
        display.drawLine(x, y + r + 2, x + r / 2, y + r - 2, invertColor(GxEPD_BLACK, invert));
    }
    // Horizon line
    display.drawLine(x - r, y + r - 2, x - r / 2, y + r - 2, invertColor(GxEPD_BLACK, invert));
    display.drawLine(x + r / 2, y + r - 2, x + r, y + r - 2, invertColor(GxEPD_BLACK, invert));
}
