desiFish/EPaper-Display-Weather-Clock/(commit log)

2025-01-09 Update README and refactor weather printing functions for clarity
2025-01-09 Refactor battery performance section in README to use a table format for clarity and add visual representation of battery life trend
2025-01-09 Add setup and configuration instructions to README for device initialization and API setup
2025-01-09 Improved power efficiency
2025-01-09 Update README to reflect version change to v0.2.0-beta and highlight power efficiency improvements
2025-01-09 Update power consumption value in README for accuracy
2025-01-10 Add important safety notes and warnings to README regarding battery configuration and USB charging
2025-01-10 Enhance README with battery performance notes, power consumption comparisons, and safety warnings for USB charging
2025-01-10 Update README with historical ICR battery performance data and add ongoing LFP battery data section
2025-01-10 Clarify BMS setup instructions in README by adding "Low Discharge Cutoff" to the 4.2V BMS note
2025-01-11 Add safety notes for DS3231 battery usage and TP5000 charging configuration in README
2025-01-11 Enhance README with clearer safety instructions for DS3231 battery usage and TP5000 charging configuration
2025-01-14 Add note about deep sleep current requirements in README
2025-01-16 * Added auto invert option for screen ghosting issue. * memory and battery efficiency improved
    [epdWeatherClockV1.ino, icons.cpp, icons.h]
2025-01-17 Update README for version 0.2.2-beta with power optimization results and documentation improvements
2025-01-17 Fix typo in sensor list in README
2025-01-29 Added better documentation, optimised further for power efficiency and better debug ability
2025-02-24 Update README and code for improved power efficiency and battery management
2025-02-24 Update README for improved power efficiency metrics and add software update instructions
2025-02-25 Enhance power management by adding extreme mode to turnOffWifi and improving comments for clarity
2025-02-25 Update README to clarify power consumption metrics for Ultra-Low Power Mode
2025-02-25 Update power consumption metrics for XIAO ESP32 C6 in README
2025-04-18 - 🔧 Enhanced overall system efficiency - 💾 Improved readability
2025-04-18 Add second cycle entry to power performance table in README
2025-04-18 Update power performance table to include second cycle entry
2025-06-03 improved nework error detection and using RTC Sleep memory for more fucntions.
    [epdWeatherClockV1.ino]
2026-04-29 arduinojson library changes and others
2026-04-29 fix: correct comparison operator in midnight temperature reset condition
    [EPaper-Display-Weather-Clock.ino]
2026-08-15 fix: update third cycle date in power performance table
2026-09-29 fix: handle null temperature values and average outdoor temperature
